skumlos/pcengine-rgb-addon/pcengine-rgb-addon.kicad_pcb

## KiCad design pcengine-rgb-addon.kicad_pcb (2018-12-23)

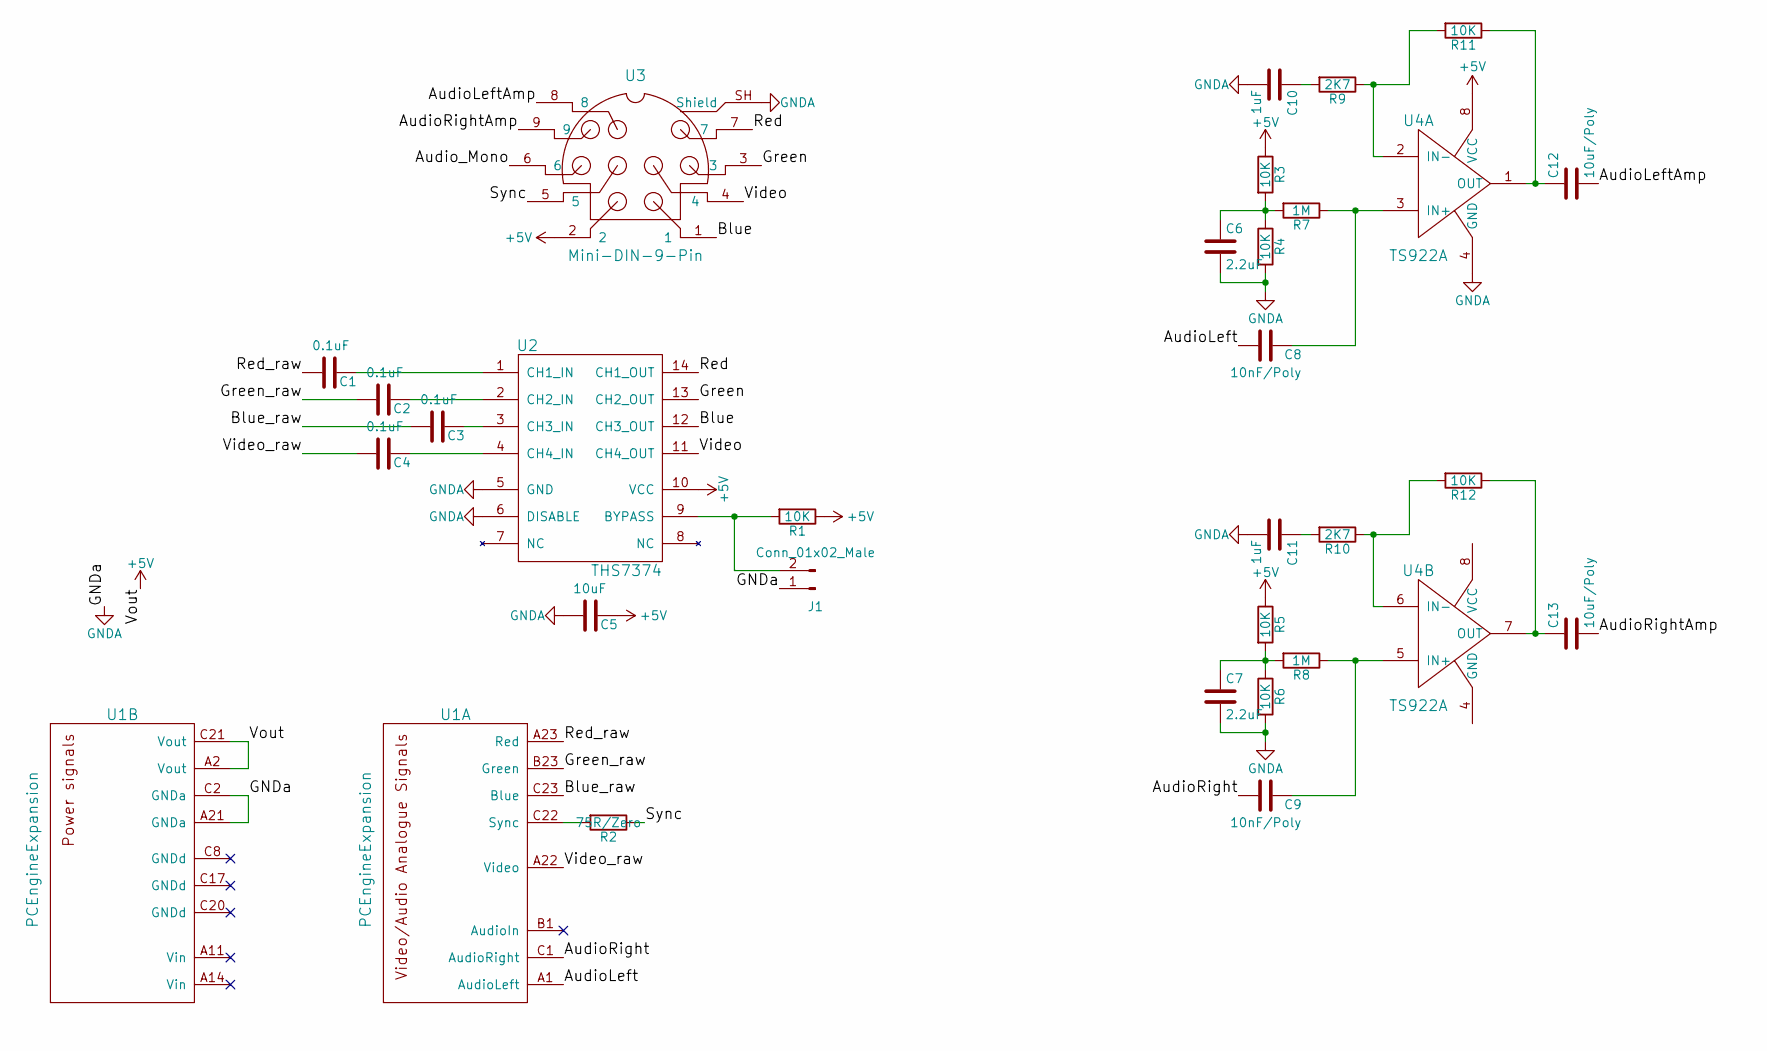
[picture p1: schematic pcengine-rgb-addon.sch]

Parts:
C1, C2, C3, C4: 0.1uF; C_0805_HandSoldering
C5: 10uF; C_0805_HandSoldering
C6, C7: 2.2uF; C_0805_HandSoldering
C8, C9: 10nF/Poly; C_Rect_L7.2mm_W2.5mm_P5.00mm_FKS2_FKP2_MKS2_MKP2
C10, C11: 1uF; C_0805_HandSoldering
C12: 10uF/Poly; CP_Elec_5x5.3
C13: 10uF/Poly; CP_Elec_5x5.3; Partnumber UWX1V100MCL1GB
J1: Conn_01x02_Male; Pin_Header_Straight_1x02_Pitch2.54mm
R1, R3, R4, R5, R6, R11, R12: 10K; R_0805_HandSoldering
R2: 75R/Zero; R_0805_HandSoldering
R7, R8: 1M; R_0805_HandSoldering
R9, R10: 2K7; R_0805_HandSoldering
U1: PCEngineExpansion; Partnumber SSQ-123-02-T-T-RA
U2: THS7374; TSSOP-14_4.4x5mm_Pitch0.65mm; Partnumber THS7374IPWR
U3: Mini-DIN-9-Pin; MINI-DIN-9PIN; Part number MDC-209
U4: TS922A; SOIC-8_3.9x4.9mm_Pitch1.27mm

Connections:
+5V: C5.1, R1.1, R3.1, R5.1, U1.A2 (Vout), U1.C21 (Vout), U2.10 (VCC), U3.2, U4.8 (VCC)
/AudioLeft: C8.2, U1.A1 (AudioLeft)
/AudioLeftAmp: C12.2, U3.8
/AudioRight: C9.2, U1.C1 (AudioRight)
/AudioRightAmp: C13.2, U3.9
/Blue: U2.12 (CH3_OUT), U3.1
/Blue_raw: C3.2, U1.C23 (Blue)
/Green: U2.13 (CH2_OUT), U3.3
/Green_raw: C2.2, U1.B23 (Green)
/Red: U2.14 (CH1_OUT), U3.7
/Red_raw: C1.2, U1.A23 (Red)
/Sync: R2.1, U3.5
/Video: U2.11 (CH4_OUT), U3.4
/Video_raw: C4.2, U1.A22 (Video)
GNDA: C5.2, C6.2, C7.2, C10.2, C11.2, J1.1, R4.2, R6.2, U1.A21 (GNDa), U1.C2 (GNDa), U2.5 (GND), U2.6 (DISABLE), U3.SH (Shield), U4.4 (GND)
unnamed: C1.1, U2.1 (CH1_IN)
unnamed: C2.1, U2.2 (CH2_IN)
unnamed: C3.1, U2.3 (CH3_IN)
unnamed: C4.1, U2.4 (CH4_IN)
unnamed: C6.1, R3.2, R4.1, R7.2
unnamed: C7.1, R5.2, R6.1, R8.2
unnamed: C8.1, R7.1, U4.3 (IN+)
unnamed: C9.1, R8.1, U4.5 (IN+)
unnamed: C10.1, R9.2
unnamed: C11.1, R10.2
unnamed: C12.1, R11.1, U4.1 (OUT)
unnamed: C13.1, R12.1, U4.7 (OUT)
unnamed: J1.2, R1.2, U2.9 (BYPASS)
unnamed: R2.2, U1.C22 (Sync)
unnamed: R10.1, R12.2, U4.6 (IN-)
unnamed: R9.1, R11.2, U4.2 (IN-)

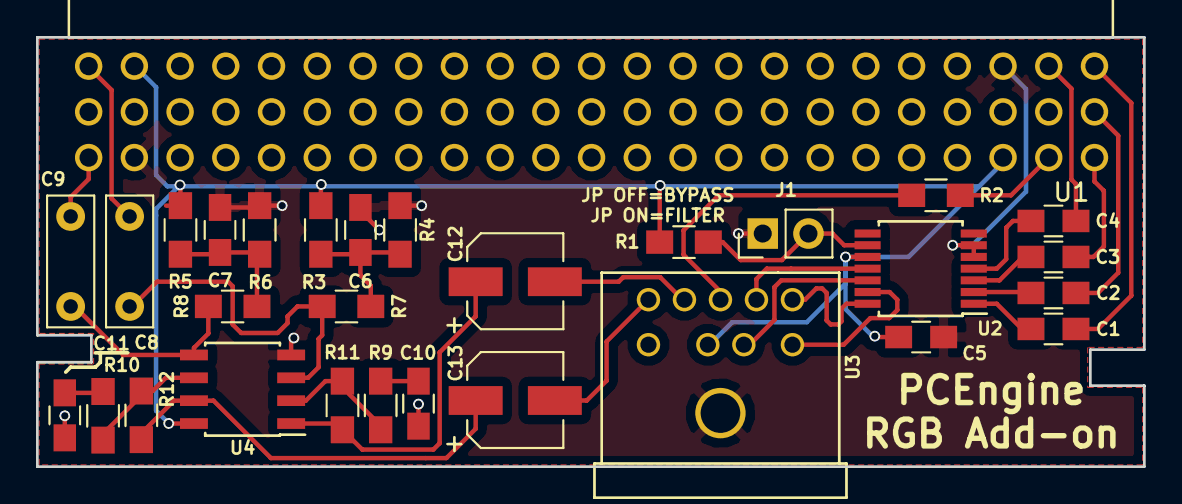
[picture p2: board pcengine-rgb-addon.kicad_pcb from above]

Board: 2 copper layers, 61.5 x 23.8 mm, 30 parts (0 on the bottom side), 31 nets.
